zheaustinlo/Austin_BlueStampEngineer/vacuum lid.stl

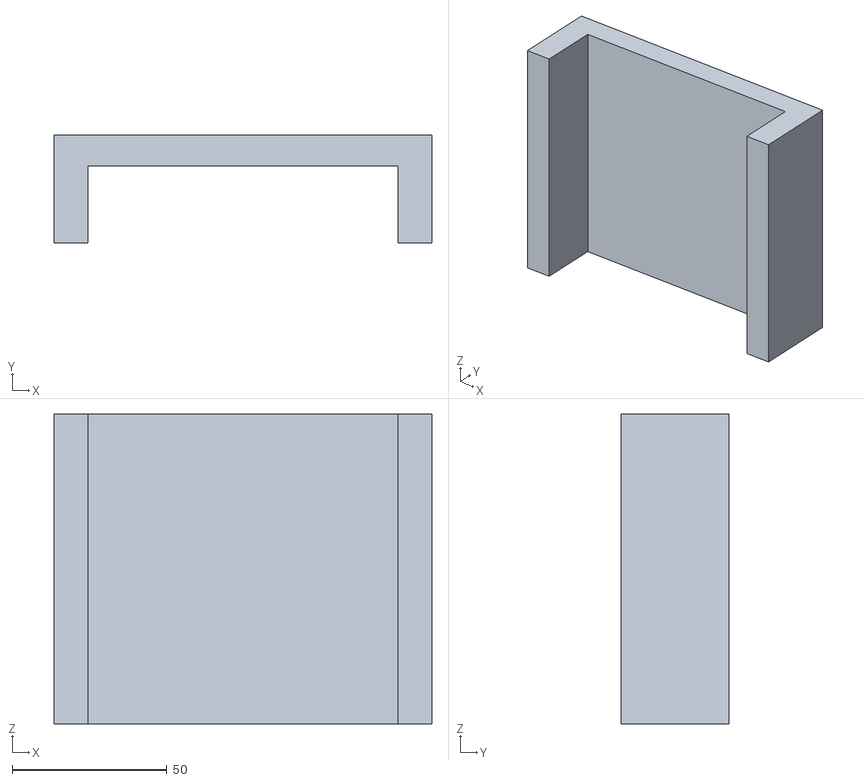
[picture p6: CAD file, 2026-07-22]
vacuum lid.stl
122.0 x 35.0 x 100.0
