zheaustinlo/Austin_BlueStampEngineer/vacuum holder(updated).stl

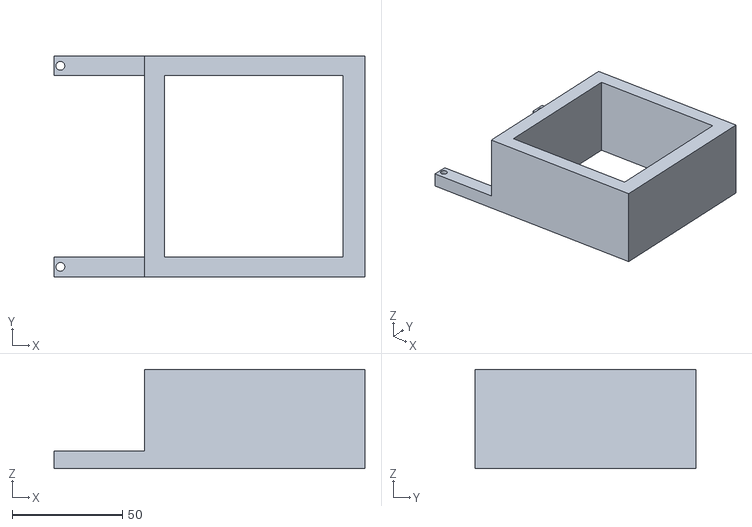
[picture p7: CAD file, 2026-07-22]
vacuum holder(updated).stl
141.0 x 100.0 x 45.0
