zheaustinlo/Austin_BlueStampEngineer/(commit log)

2026-07-02 Revise project description and update area of interest
    Updated project description to detail the functionality of the floor cleaning robot, including its sensors and autonomy. Changed area of interest from 'Unclear' to 'Electrical Engineering'.
2026-07-02 Update milestone description and project details
    Removed the initial milestone description and added details about the robot assembly and future plans.
2026-07-12 Revise second milestone details and video embed
    Updated the second milestone section with details about wiring sensors, programming obstacle detection, and challenges faced. Added a new YouTube video embed for the milestone.
2026-07-13 Add Arduino code for robot control
2026-07-13 Update link for 3-in-1 Ultimate Kit for Arduino Uno R3
2026-07-13 Update prices and add new item to index.md
    Updated prices for Arduino kit and added a new item.
2026-07-21 updated code
    Updated motor and sensor configurations for improved performance.
2026-07-21 Adjust motor speed and steering parameters
2026-07-22 Fix motor driver setup and update parts list
    Updated the motor driver configuration and corrected sensor variables in the code. Added new components to the parts list.
2026-07-22 Update index.md with schematics and code sections
    Added sections for schematics and code in the documentation.
2026-07-22 Update index.md by removing vacuum holder reference
    Removed reference to vacuum holder STL file and updated text for clarity.
2026-07-22 Refactor project documentation and remove sections
    Removed sections on vacuum holder, vacuum lid, robot images, code block instructions, and bill of materials. Updated milestone descriptions.
2026-07-23 Revise final milestone and bill of materials sections
    Updated the final milestone section with project details, modifications, and challenges faced. Revised the bill of materials for clarity and purpose.
2026-07-23 Update Bill of Materials table headers
2026-07-23 Fix table formatting in Bill of Materials section
2026-07-23 Enhance final milestone details and add BOM section
    Updated the final milestone section with additional details on troubleshooting and modifications made to the robot. Added a new section on the Bill of Materials with pricing and links.
2026-07-23 Change INTERVAL from 60000 to 30000 milliseconds
