zheaustinlo/Austin_BlueStampEngineer/headshot.jpg

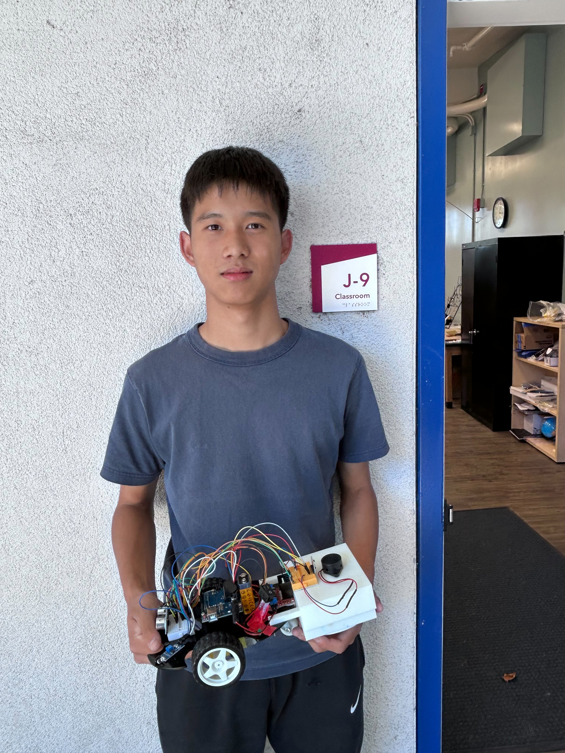
[picture p1: headshot.jpg]
headshot.jpg
