zheaustinlo/Austin_BlueStampEngineer/robotpart1.jpg

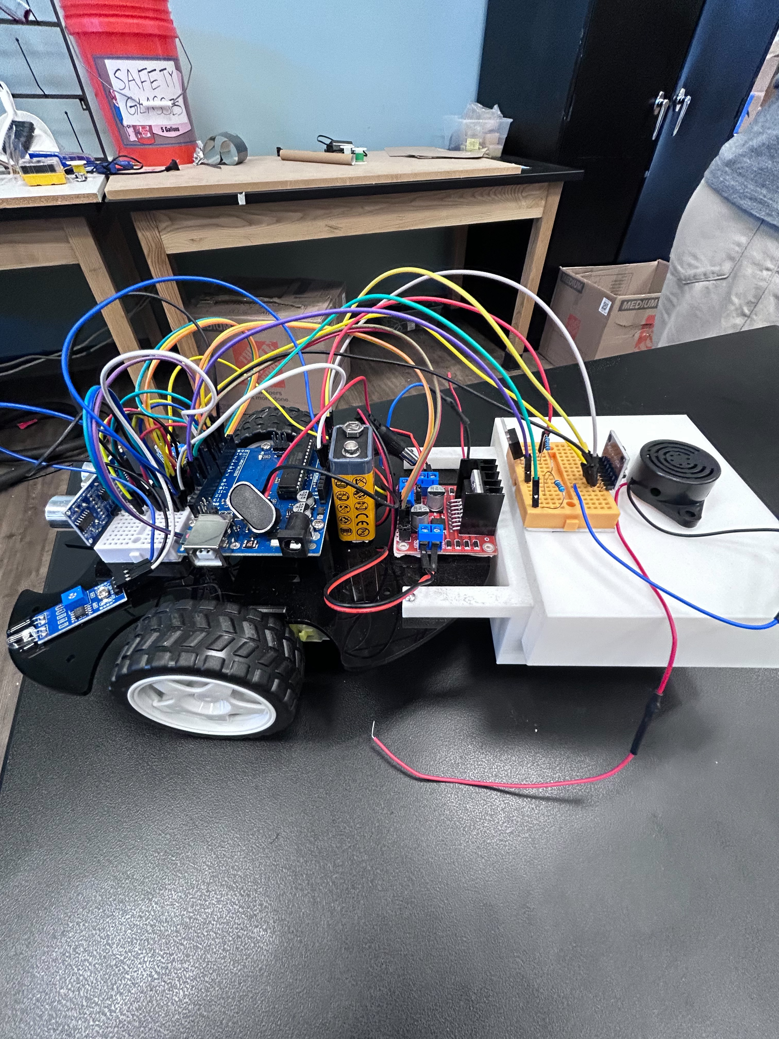
[picture p4: robotpart1.jpg]
robotpart1.jpg
