zheaustinlo/Austin_BlueStampEngineer/robotpart2.jpg

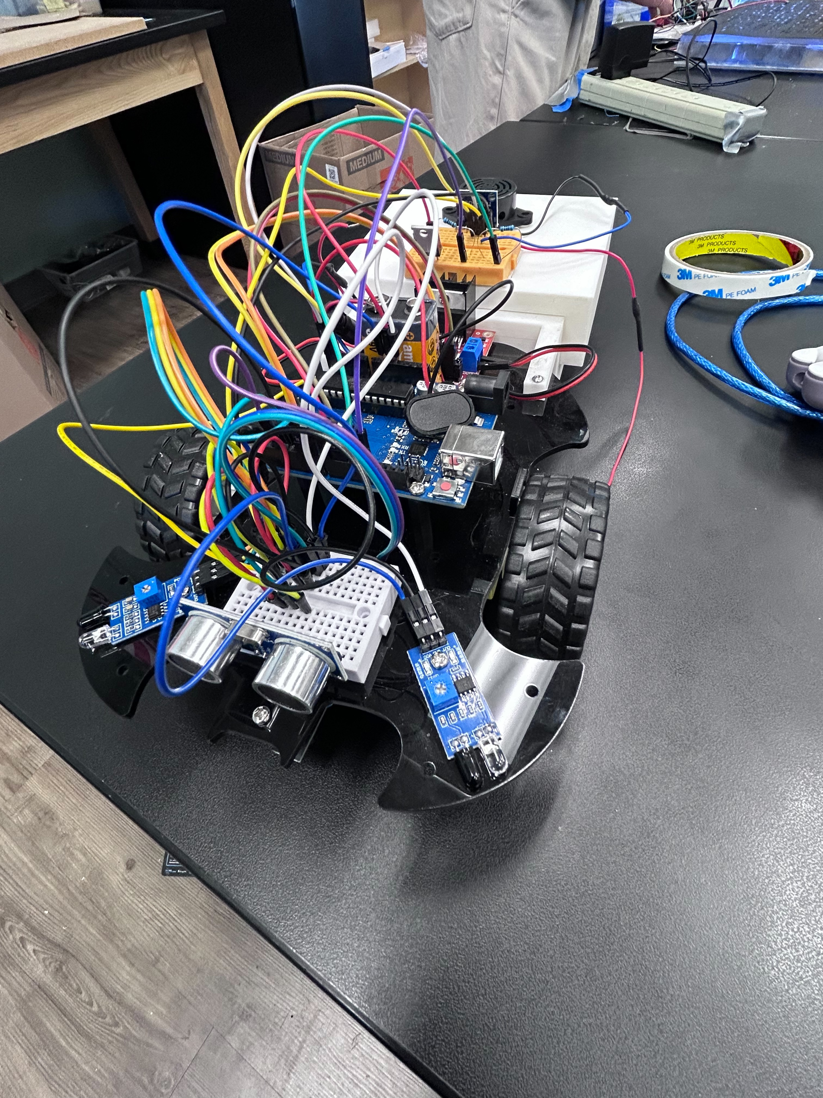
[picture p5: robotpart2.jpg]
robotpart2.jpg
